cese-dci/tp-PabloFolino/doc/Fotos/SSR.jpg

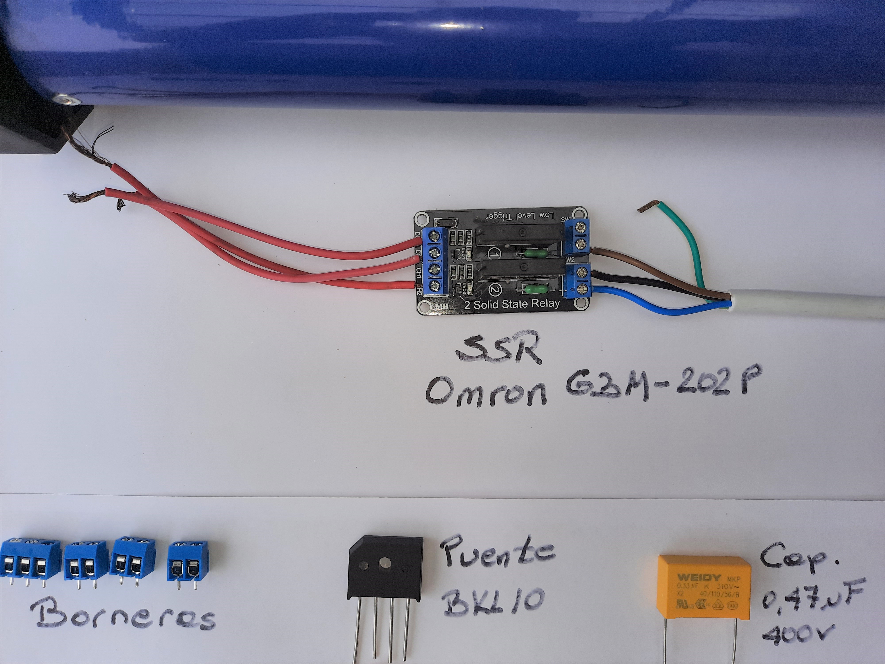
doc/Fotos/SSR.jpg
