cese-dci/tp-PabloFolino/doc/Fotos/Detalle Motor.jpg

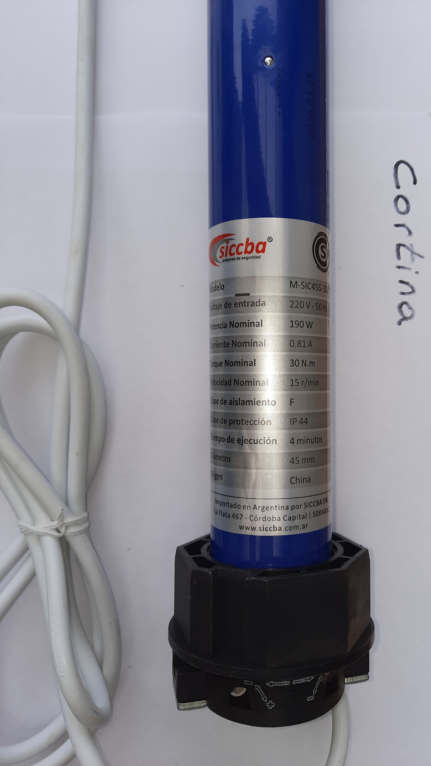
doc/Fotos/Detalle Motor.jpg
