cese-dci/tp-PabloFolino/doc/Fotos/Chapa Motor.jpg

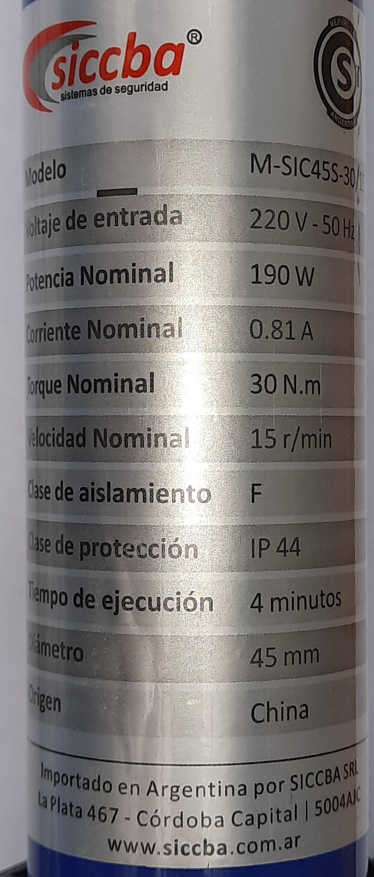
doc/Fotos/Chapa Motor.jpg
