cese-dci/tp-PabloFolino/doc/Fotos/Comp Discretos 1.jpg

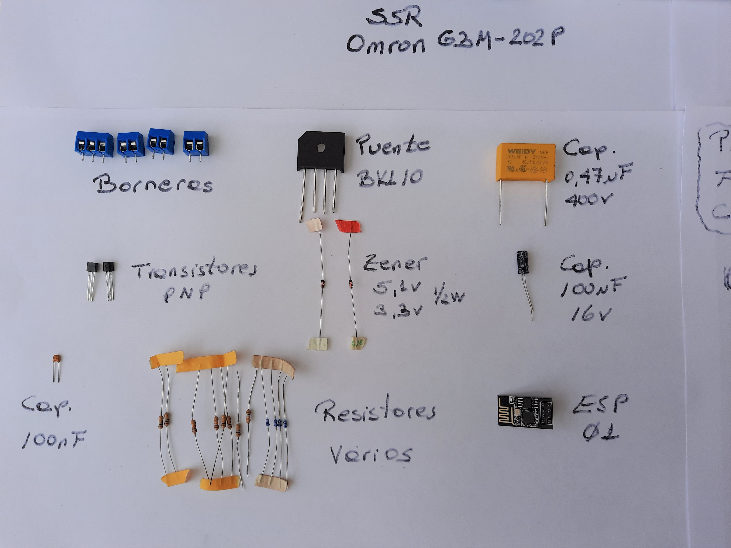
doc/Fotos/Comp Discretos 1.jpg
