cese-dci/tp-PabloFolino/doc/Fotos/Comp Discretos.jpg

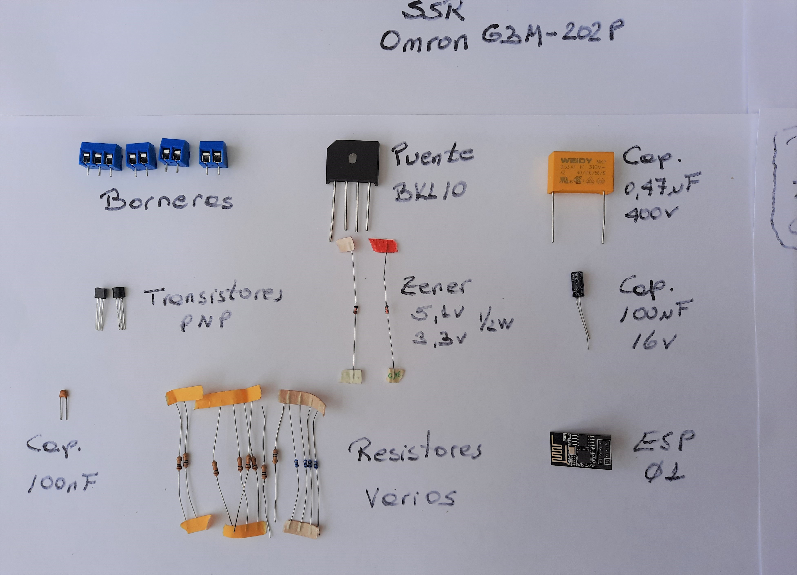
doc/Fotos/Comp Discretos.jpg
