cese-dci/tp-PabloFolino/doc/Fotos/Esquemático.jpg

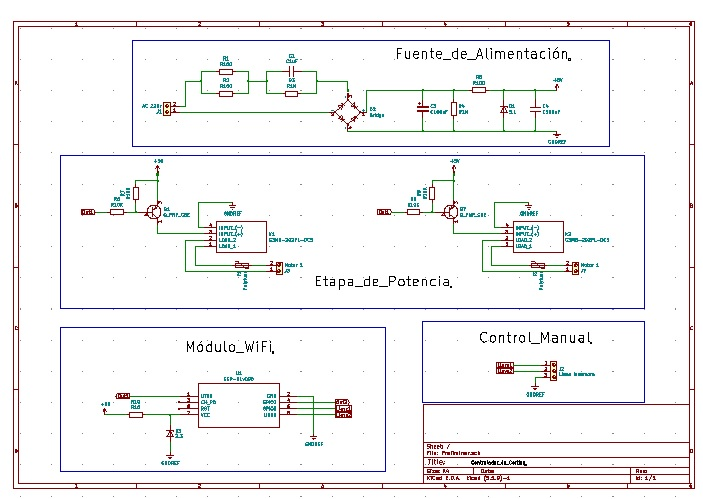
doc/Fotos/Esquemático.jpg
