cese-dci/tp-PabloFolino/doc/Fotos/Kit Commpleto.jpg

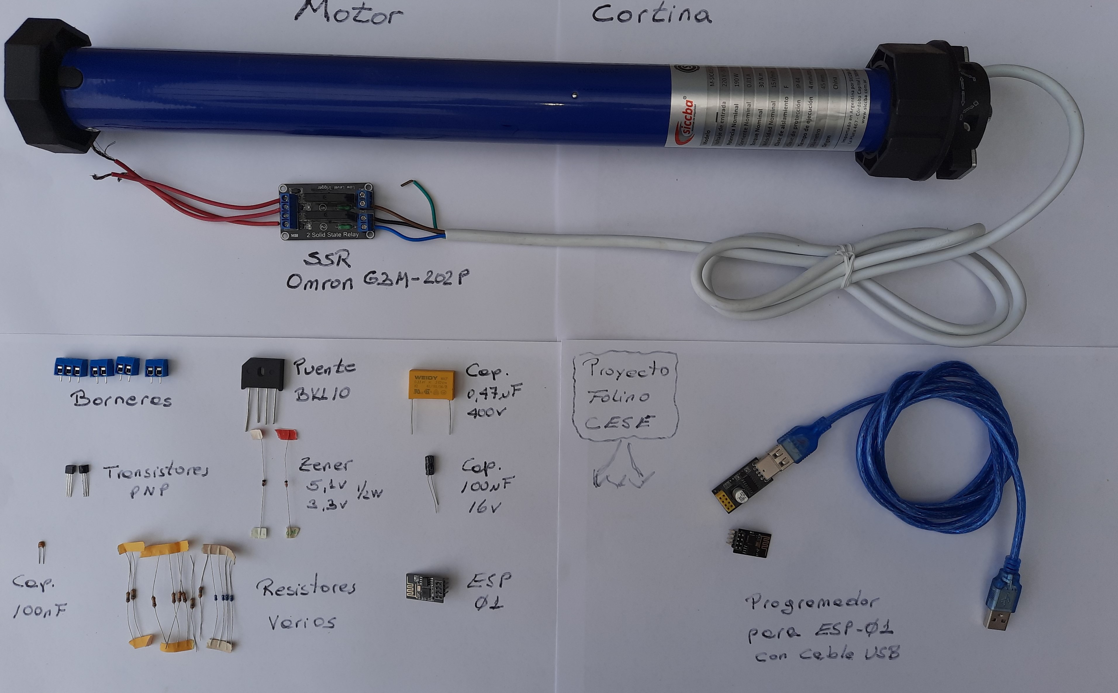
doc/Fotos/Kit Commpleto.jpg
