cese-dci/tp-PabloFolino/doc/Fotos/Prog USB2.jpg

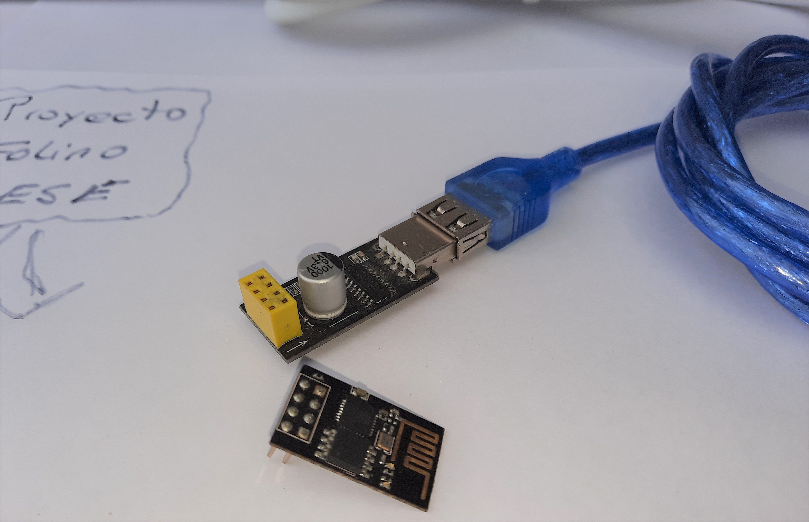
doc/Fotos/Prog USB2.jpg
