cese-dci/tp-PabloFolino/doc/Fotos/Prog USB 1.jpg

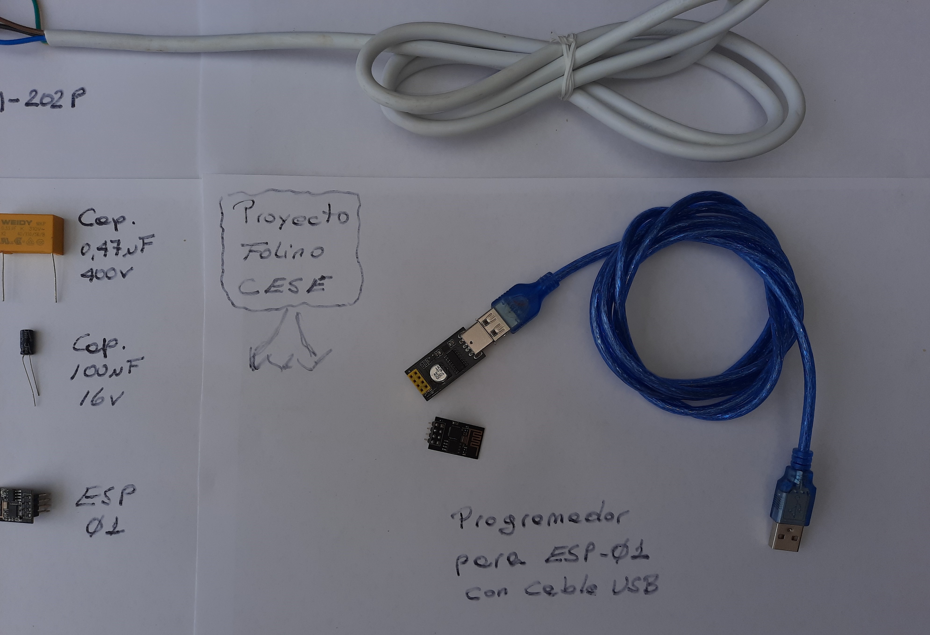
doc/Fotos/Prog USB 1.jpg
