cese-dci/tp-PabloFolino/doc/Fotos/SSR 2.jpg

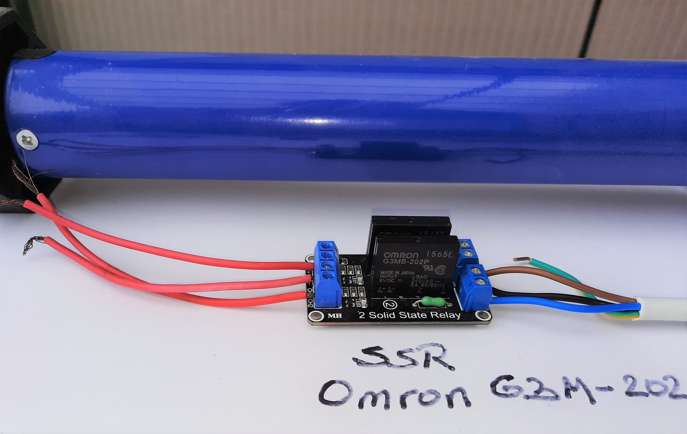
doc/Fotos/SSR 2.jpg
