cese-dci/tp-PabloFolino/doc/Listado de materiales.xlsx

Lista de materiales
Referencia | Descripción | Precio unitario | Cantidad | Precio total
R1,R2,R5 | Resistor 100 1/4w |  | 2 | 0
C1,C2 | Capacitor 390nf 400v X2 o Poliester | 30 | 3 | 90
D2 | Puente KBL 100 3a 1000v | 80 | 1 | 80
C3 | Capacitor 100uF 16v | 20 | 1 | 20
R3 | Resistor 1M 1/4 w |  |  | 0
D1 | Zener 5.1v 1/2 W | 15 | 8 | 120
C4 | Capacitor 100nf | 6 | 1 | 6
R6,7,8,9 | Resistor 10K 1/4w |  | 4 | 0
K1,2 | SSR omron G3M-202p 5v | 300 | 2 | 600
R10 | Resistor 10 1/4w |  | 1 | 0
D3 | Zener 3.3v 1/2w | 10 | 1 | 10
 |  |  |  | 0
 |  |  |  | 0
 |  |  |  | 0
 |  |  |  | 0
 |  |  |  | 0
 |  |  |  | 0
Total |  |  |  | 926
