cese-dci/tp-PabloFolino/doc/Folino_lib/bornera2.FCStd

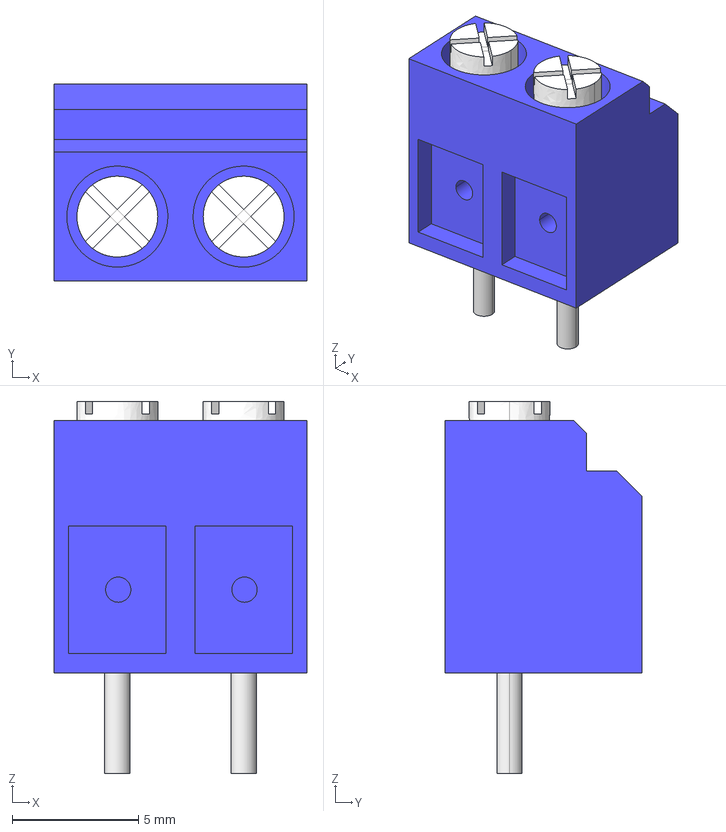
[picture p11: CAD file, 2021-04-09]
doc/Folino_lib/bornera2.FCStd
10.0 x 7.80 x 14.7 mm
