cese-dci/tp-PabloFolino/(list of files, cad)

Other CAD files:
doc/Folino_lib/bornera3.FCStd
