cese-dci/tp-PabloFolino/pcb/DriverCortina_Folino/DriverCortina_Folino.kicad_pcb

## KiCad design pcb/DriverCortina_Folino/DriverCortina_Folino.kicad_pcb (2021-04-26)

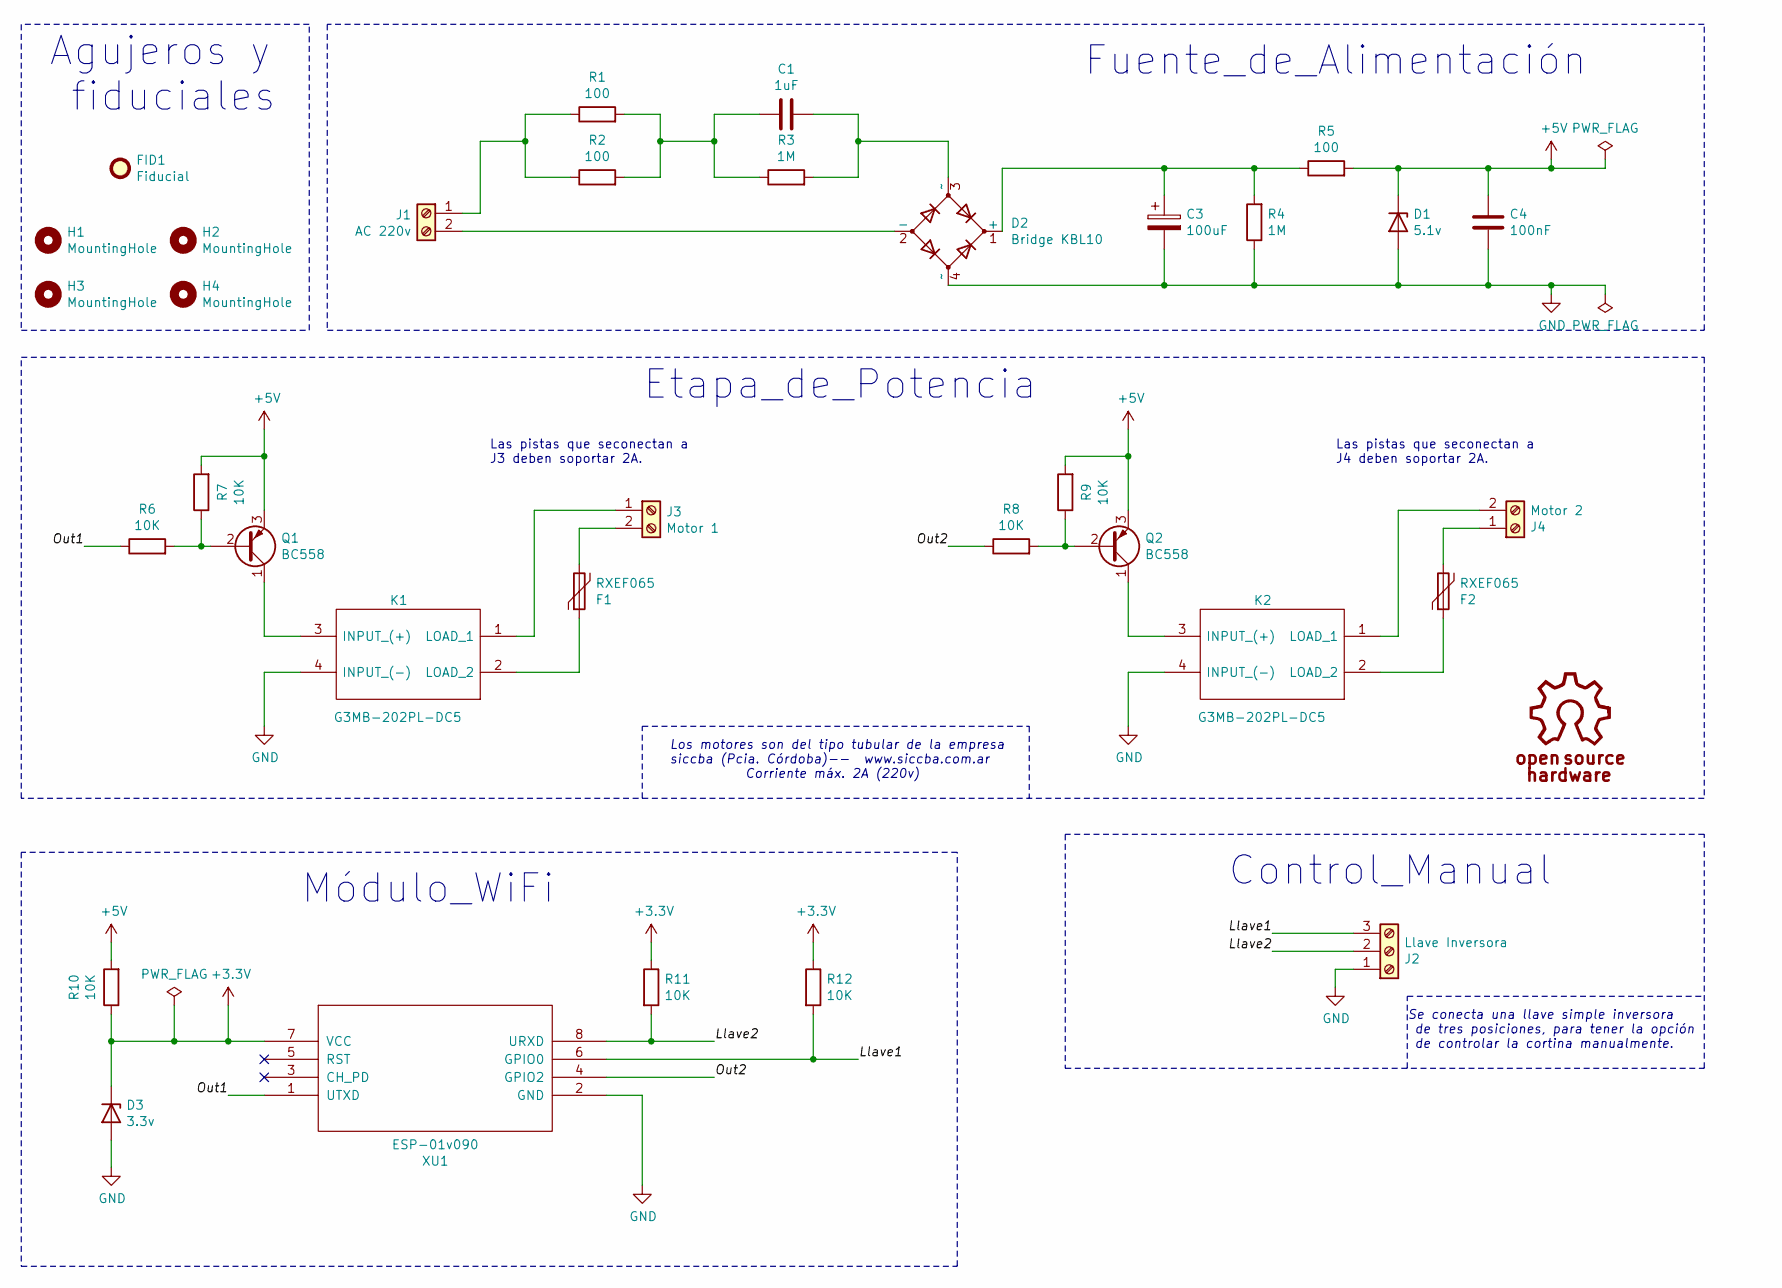
[picture p16: schematic DriverCortina_Folino.sch, Controlador WiFi para cortina]

Parts:
C1: 1uF; C_Rect_L26.5mm_W11.5mm_P22.50mm_MKS4; Manufacturer_Part_Number W42Q3105-P8*******
C3: 100uF; CP_Radial_D5.0mm_P2.50mm
C4: 100nF; C_Disc_D3.8mm_W2.6mm_P2.50mm; Manufacture_part_name C320C104K5R5TA
D1: 5.1v; D_DO-35_SOD27_P7.62mm_Horizontal; Manufacturer_Part_Number BZX55C5V1
D2: Bridge KBL10; Diode_Bridge_Vishay_KBL; Manufacturer_Part_Number KBL10
D3: 3.3v; D_DO-35_SOD27_P7.62mm_Horizontal; Manufacturer_Part_Number BZX55C3V3
F1, F2: RXEF065; C_Disc_D10.0mm_W2.5mm_P5.00mm; Manufacturer_Part_Number MF-R135-0-99
FID1: Fiducial; Fiducial_1.5mm_Mask3mm
H1, H2, H3, H4: MountingHole; MountingHole_2.5mm_Pad
J1: AC 220v; bornera_1x2_con_tornillo_5.08mm
J2: Llave Inversora; bornera_1x3_con_tornillo_5.08mm
J3: Motor 1; bornera_1x2_con_tornillo_5.08mm
J4: Motor 2; bornera_1x2_con_tornillo_5.08mm
K1, K2: G3MB-202PL-DC5; G3MB202PLDC5; Manufacturer_Part_Number G3MB-202PL-DC5; Mouser Part Number 653-G3MB-202PL-DC5
Q1, Q2: BC558; TO-92L_Inline_Wide; Manufacture_part_name BC558-ND
R1, R2, R5: 100; R_Axial_DIN0207_L6.3mm_D2.5mm_P10.16mm_Horizontal
R3, R4: 1M; R_Axial_DIN0207_L6.3mm_D2.5mm_P10.16mm_Horizontal
R6, R7, R8, R9, R10, R11, R12: 10K; R_Axial_DIN0207_L6.3mm_D2.5mm_P10.16mm_Horizontal
XU1: ESP-01v090; ESP-01

Connections:
+3V3: D3.1 (K), R10.1, R11.1, R12.1, XU1.7 (VCC)
+5V: C4.1, D1.1 (K), Q1.3 (E), Q2.3 (E), R5.2, R7.2, R9.2, R10.2
/Llave1: J2.3, R12.2, XU1.6 (GPIO0)
/Llave2: J2.2, R11.2, XU1.8 (URXD)
/Out1: R6.1, XU1.1 (UTXD)
/Out2: R8.1, XU1.4 (GPIO2)
GND: C3.2, C4.2, D1.2 (A), D2.4 (~~), D3.2 (A), J2.1, K1.4 (INPUT_(-)), K2.4 (INPUT_(-)), R4.1, XU1.2 (GND)
unnamed: C1.1, R1.2, R2.2, R3.1
unnamed: C1.2, D2.3 (~~), R3.2
unnamed: C3.1, D2.1 (+), R4.2, R5.1
unnamed: D2.2 (-), J1.2
unnamed: F1.1, K1.2 (LOAD_2)
unnamed: F1.2, J3.2
unnamed: F2.1, K2.2 (LOAD_2)
unnamed: F2.2, J4.1
unnamed: J1.1, R1.1, R2.1
unnamed: J3.1, K1.1 (LOAD_1)
unnamed: J4.2, K2.1 (LOAD_1)
unnamed: K1.3 (INPUT_(+)), Q1.1 (C)
unnamed: K2.3 (INPUT_(+)), Q2.1 (C)
unnamed: Q1.2 (B), R6.2, R7.1
unnamed: Q2.2 (B), R8.2, R9.1

Notes on the sheet:
Se conecta una llave simple inversora de tres posiciones, para tener la opción de controlar la cortina manualmente.
Los motores son del tipo tubular de la empresa siccba (Pcia. Córdoba)-- www.siccba.com.ar Corriente máx. 2A (220v)
Las pistas que seconectan a J4 deben soportar 2A.
Las pistas que seconectan a J3 deben soportar 2A.
Etapa_de_Potencia
Control_Manual
Módulo_WiFi
Fuente_de_Alimentación
Agujeros y fiduciales

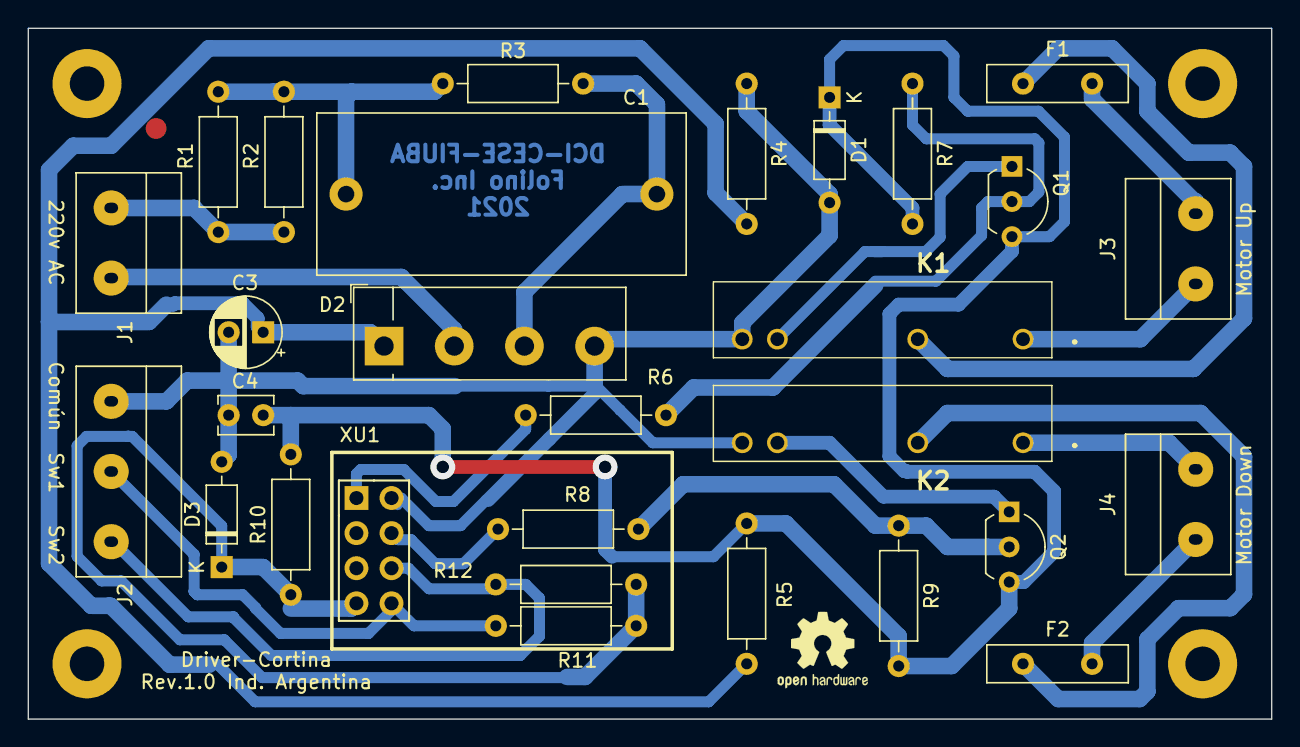
[picture p17: board DriverCortina_Folino.kicad_pcb from above]

Board: 2 copper layers, 90.0 x 50.0 mm, 34 parts (0 on the bottom side), 22 nets.
