cese-dci/tp-PabloFolino/(commit log)

2021-04-07 Esquemático y documentación
    [DriverCortina_Folino.kicad_pcb, DriverCortina_Folino.sch, Listado de materiales.xlsx]
2021-04-09 Actualización Esquemático Power_Flag
    [DriverCortina_Folino.sch]
2021-04-09 Modificación de la organización del repositorio
    [DriverCortina_Folino.kicad_pcb, DriverCortina_Folino.sch, Listado de materiales.xlsx, bornera2.FCStd, bornera3.FCStd]
2021-04-09 Corrección de errores de documentación
2021-04-10 Actualiza Footprint D3
    [DriverCortina_Folino.sch]
2021-04-11 Creación PCB y modelo 3D de SSR
    [DriverCortina_Folino.sch, G3MB_202P.stp]
2021-04-14 Se realizan las correciones del esquemático.
    [DriverCortina_Folino.kicad_pcb, DriverCortina_Folino.sch]
2021-04-19 Se actualiza PCB
    [DriverCortina_Folino.kicad_pcb, DriverCortina_Folino.sch]
2021-04-22 Mejoras de PCB
2021-04-25 Se corrigen detalles del PCB
    [DriverCortina_Folino.kicad_pcb]
