cese-dci/tp-PabloFolino/(notices)

Notices in the files:
pcb/DriverCortina_Folino/DriverCortina_Folino.kicad_pcb:
Licencia: http://creativecommons.org/licenses/by/4.0
pcb/DriverCortina_Folino/DriverCortina_Folino.sch:
Licencia: CC BY 4.0
